elena484-r/rehab-glove-ai/docs/schema_kicad.pdf

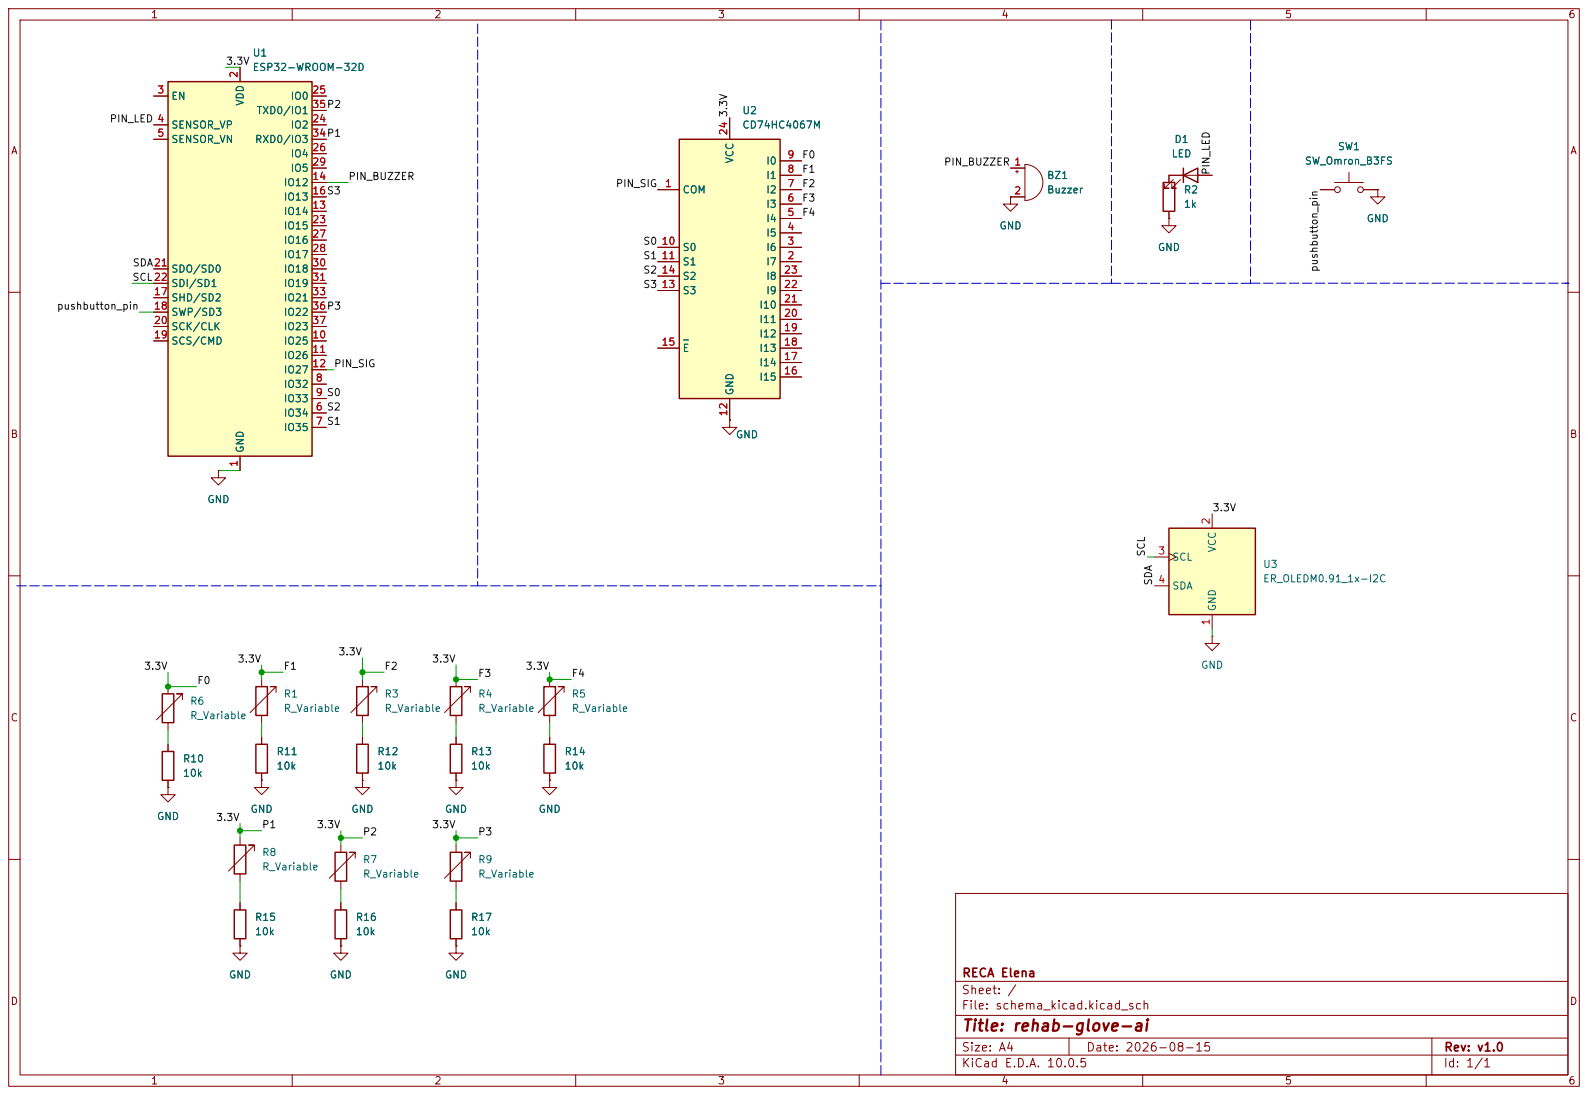
[picture p1: page 1]

RECA Elena
Sheet: /
File: schema_kicad.kicad_sch
Title: rehab-glove-ai

Size: A4 | Rev: v1.0
KiCad E.D.A. 10.0.5 | Id: 1/1
