elena484-r/rehab-glove-ai/(commit log)

2026-07-13 feat: add ESP32 sensor reading with EMA filter, Flask server and Claude coach API
2026-07-19 Update WiFi credentials and calibration comments
2026-07-24 Modify flexMin values for hand calibration
    Updated flexMin array values for calibration.
2026-08-01 Simplify description of pressure sensors in README
2026-08-06 feat: add complete UI, KNN model, training pipeline and Raspberry Pi interface
2026-08-13 Suppression des fichiers
2026-08-13 Suppression de fichiers
2026-08-13 Mise a jour des codes
2026-08-15 Add patient_data_simulation.json file
2026-08-22 Ajout des fichiers finaux
2026-08-22 Fix print statement formatting in couche1_knn.py
2026-08-22 Update print statement from 'Hello' to 'Goodbye'
